damienmaguire/BMW-F11-EV-Conversion/Software/FlexRay/dde-emulator/BASE.md

# Base of the DDE emulator

| What | Where | Commit |
|---|---|---|
| Upstream | https://github.com/dynm/pico-flexray, branch `feature/frame-blocker` | `5c77833ea0b1f9337de2973e54bc3378c0533d34` |
| Local, not on any remote | pass-through build (the known-good firmware) | `9a9ddcc` |
| Local, not on any remote | `ts-capture-fixed` (FIXED timestamped capture build) | `acf675e5693eadddcd28ed0d1cda9be54f53aaa5` |
| Local, not on any remote | `dde-emu-v1h` (this work, v1h.2) | `bc62e95` (v1e was `a2f3321`/`d7e490a`, v1c `60e749b`, v1b `f120e10`, v1 `954110e`) |

History, oldest first:

```
5c77833 Enhance FlexRay functionality by introducing frame blocking and forwarding features. Added flexray_blo
9a9ddcc Pass-through build: disable injection + blocker by default, target Pico 2 (pico2/rp2350-arm-s)
ef2f378 ts-capture FIXED: hardware frame timestamps on the known-good 9a9ddcc pass-through repeater
37fcfba sim: model of flexray_transparent.pio mid-frame TXEN release on real sync frames
7cc598b fr_schedule_analyze: refine_cycle ignores sparse slots (min_len=max(3,nmax//20)), require >=3 slots in
acf675e ts-capture: crc_fail counter in TS info (was uncounted), PICO_FR_USB_FAST option (1 KB vendor IN trans
854bbe3 dde-emu: table generator and bit-level model from run 5 capture
4530346 dde-emu: host-compilable core (frame build, CRC/E2E, schedule, lock FSM) + host test
5698464 dde-emu: firmware (PICO_FLEXRAY_DDE_EMU=ON): transmit DDE static frames on FR1
954110e dde-emu: logger --emulate, emulator stats, Python validation tests   (= v1)
ab10e9c dde-emu v1b: fix false 'TX SM stuck' fault that dropped 0x3D; first-fault record, stats v2
9a7c938 tests: replay car run 1 (f11_emu1.csv) through dde_emu.c on the host
f120e10 logger: read emu stats v2 (128 bytes), show first fault, print EMU FAULT once   (= v1b)
a256526 dde-emu v1c: send dynamic 0xE6/0xFB/0xE8 and the pre-ign statics; stats v3
cd3f70d tests: v1c dynamic frames - run 5 bytes/minislots, run 1/2 replays, unsure cases
64375c7 logger: read emu stats v3 (192 bytes), show the v1c dynamic frames on the emu line
60e749b tests: cross-check v1c against the DDE flash decode (E2E ID 0x37, base/rep, periods, 0xFF fill, FB L7 0xFFF)
fafdba3 dde_emu v1d: 0x5C NM (KL15/NM-gated, 60 s hard ceiling), 0x10A/0x142/0x68, KL15 from 0xF1, FIFO top-up, stats v4
c1ac5fd tests: v1d - 0x142/0x10A/0x68 vs run 5, KL15/NM unit checks, replay KL15/NM model
af3af72 V2 board (Pi_Flex_V2) for the DDE emulator: PT-CAN capture, MCP251863 RX ONLY
366997d logger: emu stats v4 (v1d KL15/NM/ceiling, 0x10A/0x142/0x68), PT-CAN as bus 2, can= counts
29eae7a dde-emu v1e: FlexRay content follows KL15 after off
9653dc9 dde-emu v1e: PT-CAN DDE/EGS frame emulation on the V2 board (opt-in TX)
a2f3321 logger: --can-tx / --can-tx-ids (v1e PT-CAN TX), cantx: status line; run.sh ptcan tests   (= v1e)
d7e490a dde-emu v1e: plain-English comments in the PT-CAN emulator (comments only, V2 UF2 byte-identical)
7dec502 dde-emu v1f WIP: non-blocking console, keep-grid catch-up, NM release 46/30 s, 0x397 blips + OFF walk
55d14fa dde-emu v1f: 16 frames per pass, loop-gap/late stats, own TX logged via the MCP TX event FIFO
46535d5 dde-emu v1f: check_emu_capture.py (own-TX slots, 0x397, foreign IDs, brake signals)   (= v1f)
58cf388 dde-emu v1g: opt-in fake engine start (CAS ST_KL D + brake)
895fe20 dde-emu v1g.2: stop USB record drops; FW_VERSION; logger version check   (= v1g.2)
7514b68 dde-emu v1h: PICO_FR_USB_FAST (1 KB transfers), start profiles short/realistic/run8, echo-miss diagnostics   (= v1h)
d3ebc30 dde-emu v1h.1: gear shifting P/R/N/D (lever 0x197 + brake 0x173), standalone build, checker --gear   (= v1h.1)
bc62e95 dde-emu v1h.2: snapshot reuse (no stale PT-CAN frames), engine/gear out of the FR header ISR, ISR tables in RAM, re-arm guard 70 us, E6 grid fix   (= v1h.2)
```

**v1h.2 patches** (`v1h2/patches/0020..0027`): `git format-patch --start-number 20
d7e490a..` on top of the v1e series (`v1e/patches/0012..0019`). 0020..0026 are
the commits above, unchanged. 0027 is `bc62e95` with one difference: the test
vector `tests/host/run9_ptcan_rx.txt.gz` (all PT-CAN frames received in car run
9) has the immobiliser, VIN and diagnostic IDs (0x80, 0x85, 0x351, 0x380, 0x580,
0x592, 0x598, 0x5C0 and 0x6xx; 144 frames) removed for publication. The test
that uses it gives the same transmitted frames with or without them, and the
host tests (`run.sh`) pass. `source/` carries the same cleaned file.

`source/` is at v1h.2: a rebuild gives the four v1h.2 UF2s byte for byte
(same SHA-256 as `v1h2/firmware/SHA256SUMS`).

`patches/` is the series ts-capture-fixed..dde-emulator. These are 11 patches:
0001–0004 = v1 (`git format-patch ts-capture-fixed..954110e`, unchanged),
0005–0007 = v1b (`git format-patch --start-number 5 954110e..f120e10`, unchanged), and
0008–0011 = v1c (`git format-patch --start-number 8 f120e10..dde-emulator`).
Apply them with `git am patches/*.patch` on a checkout of `ts-capture-fixed`.

`ts-capture-fixed` is not on any remote, so `source/` holds the full source
tree of `dde-emulator` (firmware, tests, tools; no images, web UI or build
output). That tree builds the same code as the shipped v1c UF2: the `.text`
section is byte-identical to the build that made it (checked again for v1c).

With `PICO_FLEXRAY_DDE_EMU=OFF` (the default), the tree builds the FIXED
capture firmware. Every symbol has the same size as in a ts-capture-fixed
build. The UF2 hash differs only because the build path is embedded.
