damienmaguire/BMW-F11-EV-Conversion/F11_DDE_Pinout.ods

Sheet: A460 58-pin
BMW F11 520d DDE (EDC17C50) — Connector A460*2B
58-pin black component connector — Digital diesel electronics
Pin | Type | Description / Signal type | Connection / Measuring information
1 | E | Supply, terminal 87 | Fuse F03
2 | M | Ground | Ground point
3 | E | Supply, terminal 87 | Fuse F03
4 | M | Ground | Ground point
5 | E | Supply, terminal 87 | Fuse F03
6 | M | Ground | Ground point
7 | -- | Not used
8 | A | Activation Cut-out relay, electric fan | Cut-out relay, electric fan
9 | -- | Not used
10 | A | Activation Electric fan | Electric fan
11 | E | Engine start signal | Car access system
12 | E | Supply, terminal 15 | Car access system
13 | A | Activation DDE main relay | DDE main relay
14 | E/A | FlexRay bus signal | Central gateway module
15 | E/A | FlexRay bus signal | Central gateway module
16 | -- | Not used
17 | -- | Not used
18 | E | Wake-up signal | Connector, terminal 15 wake-up signal
19 | -- | Not used
20 | A | Engine start signal | DC/DC converter
21 | A | Speed signal | Diagnosis socket
22 | M | Ground | Engine breather heater
23 | A | Activation Fuel filter heating | Fuel filter heating
24 | -- | Not used
25 | E/A | LIN bus signal | Intelligent battery sensor
26 | -- | Not used
27 | -- | Not used
28 | -- | Not used
29 | -- | Not used
30 | -- | Not used
31 | -- | Not used
32 | -- | Not used
33 | M | Ground | Accelerator pedal module
34 | E | Signal Accelerator pedal module | Accelerator pedal module
35 | A | Supply Accelerator pedal module | Accelerator pedal module
36 | E/A | CAS sub-bus | Car access system
37 | E/A | PT-CAN2 bus signal | PT-CAN2 bus connection
38 | E/A | PT-CAN2 bus signal | PT-CAN2 bus connection
39 | E | Signal Zero-gear sensor | Zero-gear sensor
40 | M | Ground | Zero-gear sensor
41 | M | Ground | Accelerator pedal module
42 | E | Signal Accelerator pedal module | Accelerator pedal module
43 | A | Supply Accelerator pedal module | Accelerator pedal module
44 | -- | Not used
45 | -- | Not used
46 | -- | Not used
47 | -- | Not used
48 | -- | Not used
49 | -- | Not used
50 | -- | Not used
51 | -- | Not used
52 | -- | Not used
53 | A | Supply Zero-gear sensor | Zero-gear sensor
54 | E | Signal Clutch module | Clutch module
55 | E/A | PT-CAN bus signal | PT-CAN bus connection
56 | E/A | PT-CAN bus signal | PT-CAN bus connection
57 | -- | Not used
58 | -- | Not used

Sheet: X2411 96-pin
BMW F11 520d DDE (EDC17C50) — Connector X2411
96-pin black component connector — Digital diesel electronics
Pin | Type | Description / Signal type | Connection / Measuring information
1 | A | Activation Injector 2 | Injector 2
2 | A | Activation Injector 4 | Injector 4
3 | A | Activation Injector 2 | Injector 2
4 | A | Activation Injector 3 | Injector 3
5 | -- | Not used
6 | A | Activation Swirl flap actuator | Swirl flap actuator
7 | A | Activation Swirl flap actuator | Swirl flap actuator
8 | -- | Not used
9 | E | Signal, temperature sensor | Hot-film air mass meter
10 | E | Signal Exhaust temperature sensor before catalytic converter | Exhaust temperature sensor before catalytic converter
11 | M | Ground Exhaust temperature sensor before catalytic converter | Exhaust temperature sensor before catalytic converter
12 | E | Signal Exhaust gas temperature sensor before particle filter | Exhaust gas temperature sensor before particle filter
13 | M | Ground Exhaust gas temperature sensor before particle filter | Exhaust gas temperature sensor before particle filter
14 | M | Ground | Swirl flap actuator
15 | E | Signal Swirl flap actuator | Swirl flap actuator
16 | A | Supply Swirl flap actuator | Swirl flap actuator
17 | E | Signal Charge-air temperature sensor | Charge-air temperature sensor
18 | M | Ground Exhaust-gas temperature sensor after exhaust-gas recirculation cooler | Exhaust-gas temperature sensor after exhaust-gas recirculation cooler
19 | M | Ground Boost pressure actuator | Boost pressure actuator
20 | E | Signal Boost pressure actuator | Boost pressure actuator
21 | -- | Not used
22 | A | 5 V supply | Boost pressure actuator
23 | E/A | BSD bus signal | Alternator
24 | A | Activation Exhaust recirculation actuator | Exhaust recirculation actuator
25 | A | Activation Injector 1 | Injector 1
26 | A | Activation Injector 3 | Injector 3
27 | A | Activation Injector 1 | Injector 1
28 | A | Activation Injector 4 | Injector 4
29 | -- | Not used
30 | M | Ground | Preheating control unit
31 | M | Ground Oil-level sensor | Oil-level sensor
32 | M | Ground | Coolant temperature sensor
33 | E | Signal, temperature sensor | Coolant temperature sensor
34 | E | Oxygen sensor signal | Oxygen sensor after catalytic converter
35 | M | Ground | Oxygen sensor after catalytic converter
36 | E | Oxygen sensor signal | Oxygen sensor after catalytic converter
37 | E | Oxygen sensor signal | Oxygen sensor after catalytic converter
38 | M | Ground | Throttle valve
39 | E | Signal Throttle valve | Throttle valve
40 | A | Supply Throttle valve | Throttle valve
41 | E | Signal Charge-air temperature sensor | Charge-air temperature sensor
42 | E | Signal Exhaust-gas temperature sensor after exhaust-gas recirculation cooler | Exhaust-gas temperature sensor after exhaust-gas recirculation cooler
43 | M | Ground | Exhaust recirculation actuator
44 | E | Signal Exhaust recirculation actuator | Exhaust recirculation actuator
45 | A | Supply Exhaust recirculation actuator | Exhaust recirculation actuator
46 | -- | Not used
47 | -- | Not used
48 | A | Activation Exhaust recirculation actuator | Exhaust recirculation actuator
49 | A | Activation Throttle valve | Throttle valve
50 | A | Activation | Boost pressure actuator
51 | A | Activation Rail pressure control valve | Rail pressure control valve
52 | E | Oxygen sensor signal | Oxygen sensor after catalytic converter
53 | -- | Not used
54 | A | Supply Boost pressure sensor | Boost pressure sensor
55 | E | Signal Boost pressure sensor | Boost pressure sensor
56 | A | Supply Fuel pressure/temperature sensor | Fuel pressure/temperature sensor
57 | E | Signal, temperature sensor | Fuel pressure/temperature sensor
58 | E | Signal, pressure sensor | Fuel pressure/temperature sensor
59 | M | Ground | Fuel pressure/temperature sensor
60 | E | Signal Oxygen sensor before catalytic converter | Oxygen sensor before catalytic converter
61 | M | Ground | Oxygen sensor before catalytic converter
62 | M | Ground Exhaust backpressure sensor | Exhaust backpressure sensor
63 | E | Signal Exhaust backpressure sensor | Exhaust backpressure sensor
64 | A | Supply Exhaust backpressure sensor | Exhaust backpressure sensor
65 | E | Signal, temperature sensor | Hot-film air mass meter
66 | -- | Not used
67 | E | Signal Oil-level sensor | Oil-level sensor
68 | E | Signal, pressure sensor | Oil pressure switch
69 | -- | Not used
70 | E/A | LIN bus signal | Preheating control unit
71 | -- | Not used
72 | -- | Not used
73 | A | Activation Throttle valve | Throttle valve
74 | A | Activation | Boost pressure actuator
75 | -- | Not used
76 | A | Activation | Electric changeover valve, engine mount
77 | A | Activation Electric changeover valve, bypass valve, EGR cooler | Electric changeover valve, bypass valve, EGR cooler
78 | M | Ground | Boost pressure sensor
79 | M | Ground Exhaust pressure sensor before turbocharger | Exhaust pressure sensor before turbocharger
80 | E | Signal Exhaust pressure sensor before turbocharger | Exhaust pressure sensor before turbocharger
81 | A | Supply Exhaust pressure sensor before turbocharger | Exhaust pressure sensor before turbocharger
82 | E | Signal Camshaft sensor | Camshaft sensor
83 | M | Sensor ground | Camshaft sensor
84 | E | Signal Oxygen sensor before catalytic converter | Oxygen sensor before catalytic converter
85 | E | Signal Oxygen sensor before catalytic converter | Oxygen sensor before catalytic converter
86 | M | Ground Rail pressure sensor | Rail pressure sensor
87 | E | Signal Rail pressure sensor | Rail pressure sensor
88 | A | Supply Rail pressure sensor | Rail pressure sensor
89 | E | Signal, temperature sensor | Hot-film air mass meter
90 | M | Ground | Hot-film air mass meter
91 | M | Ground | Crankshaft sensor
92 | E | Signal Crankshaft sensor | Crankshaft sensor
93 | A | Supply Crankshaft sensor | Crankshaft sensor
94 | E | Signal Oxygen sensor before catalytic converter | Oxygen sensor before catalytic converter
95 | -- | Not used
96 | A | Activation Volume control valve | Volume control valve

Sheet: Notes
Notes — BMW F11 520d DDE Pinout
Source: BMW ISTA / TIS pin assignment for A460*2B and X2411 on the EDC17C50 (N47, F11 520d).
Type codes:
E = Input
A = Output / Activation
E/A = Bidirectional
M = Ground
-- = Not used
Key pins for the EV conversion / emulator:
A460*2B pins 14 & 15 — FlexRay bus signals (to central gateway)
A460*2B pins 1, 3, 5 — Terminal 87 (+12 V supply)
A460*2B pins 2, 4, 6 — Ground
A460*2B pin 12 — Terminal 15
A460*2B pin 18 — Wake-up signal
A460*2B pins 33–35 & 41–43 — Accelerator pedal module (dual track)
Colour coding in the sheets:
Green = FlexRay
Yellow = Terminal 87 power
Blue = Main grounds (pins 2/4/6)
Grey = Not used
Created for the F11 520d EV conversion project.
