damienmaguire/BMW-F11-EV-Conversion/Design/FlexRay/Pi_Flex_V1_3D.jpg

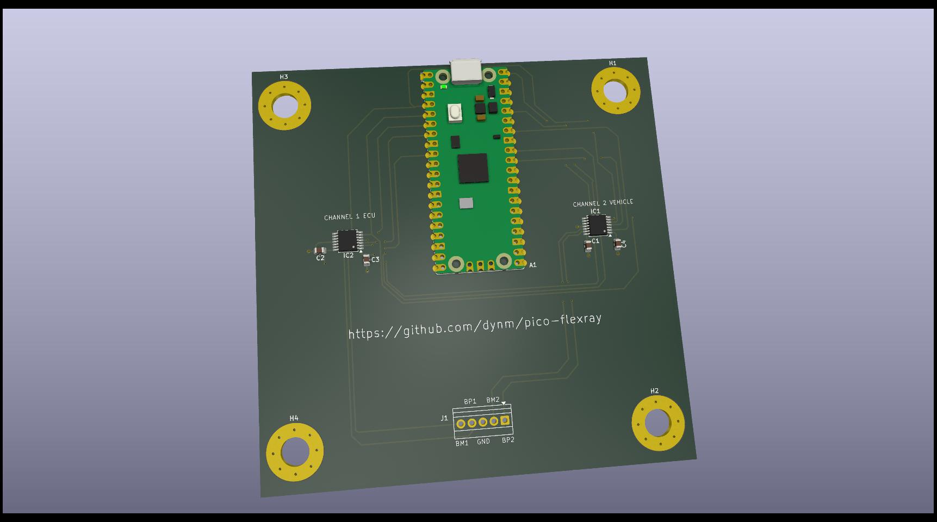
Design/FlexRay/Pi_Flex_V1_3D.jpg
