damienmaguire/BMW-F11-EV-Conversion/Design/FlexRay/Pi_Flex_V1.kicad_pcb

## KiCad design Design/FlexRay/Pi_Flex_V1.kicad_pcb (2026-10-28)

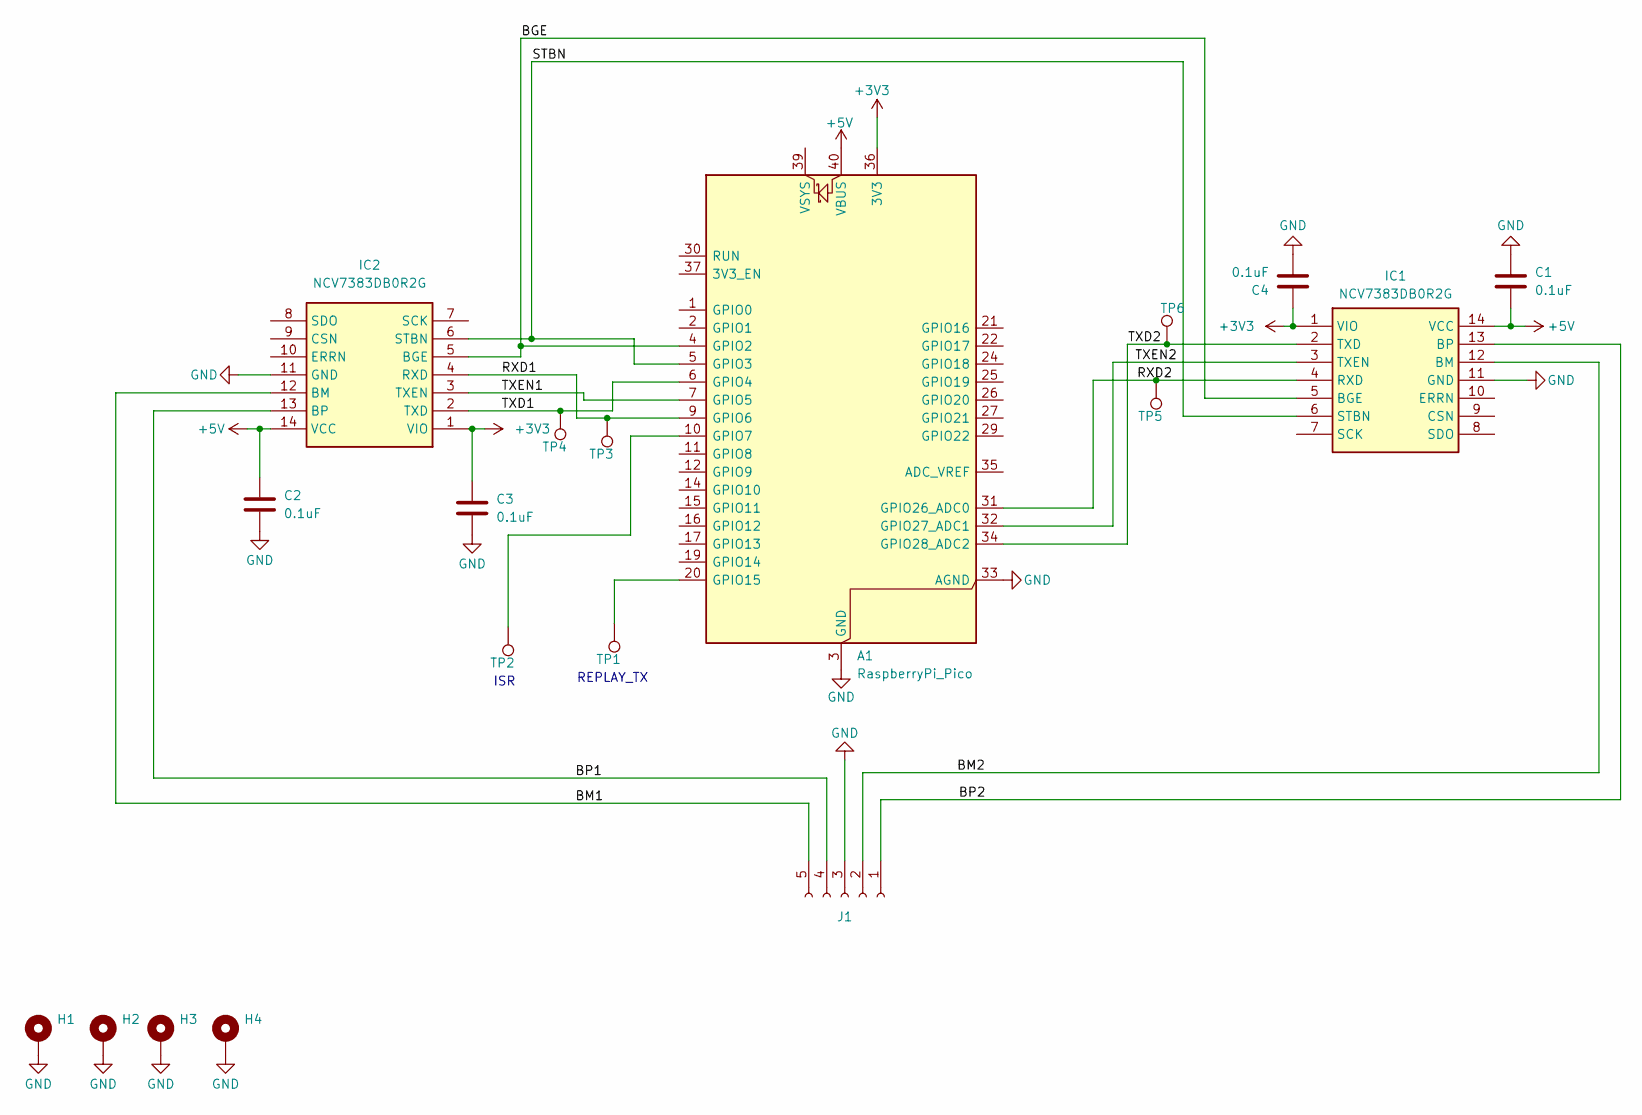
[picture p3: schematic Pi_Flex_V1.kicad_sch]

Parts:
A1: RaspberryPi_Pico; RaspberryPi_Pico_Common_Unspecified
C1, C2, C3, C4: 0.1uF; C_0805_2012Metric
H1, H2, H3, H4: MountingHole_Pad; MountingHole_6.4mm_M6_Pad_Via
IC1, IC2: NCV7383DB0R2G; TSSOP-14_4.4x5mm_P0.65mm; Manufacturer_Part_Number NCV7383DB0R2G; Mouser Part Number 863-NCV7383DB0R2G
J1: Conn_01x05_Socket; TerminalBlock_Xinya_XY308-2.54-5P_1x05_P2.54mm_Horizontal
TP1, TP2, TP3, TP4, TP5, TP6: TestPoint; TestPoint_THTPad_D2.5mm_Drill1.2mm

Connections:
+3V3: A1.36 (3V3), C3.1, C4.1, IC1.1 (VIO), IC2.1 (VIO)
+5V: A1.40 (VBUS), C1.2, C2.1, IC1.14 (VCC), IC2.14 (VCC)
/BGE: A1.4 (GPIO2), IC1.5 (BGE), IC2.5 (BGE)
/BM1: IC2.12 (BM), J1.5
/BM2: IC1.12 (BM), J1.2
/BP1: IC2.13 (BP), J1.4
/BP2: IC1.13 (BP), J1.1
/RXD1: A1.9 (GPIO6), IC2.4 (RXD), TP3.1
/RXD2: A1.31 (GPIO26_ADC0), IC1.4 (RXD), TP5.1
/STBN: A1.5 (GPIO3), IC1.6 (STBN), IC2.6 (STBN)
/TXD1: A1.6 (GPIO4), IC2.2 (TXD), TP4.1
/TXD2: A1.34 (GPIO28_ADC2), IC1.2 (TXD), TP6.1
/TXEN1: A1.7 (GPIO5), IC2.3 (TXEN)
/TXEN2: A1.32 (GPIO27_ADC1), IC1.3 (TXEN)
GND: A1.3 (GND), A1.8 (GND), A1.13 (GND), A1.18 (GND), A1.23 (GND), A1.28 (GND), A1.33 (AGND), A1.38 (GND), C1.1, C2.2, C3.2, C4.2, H1.1, H2.1, H3.1, H4.1, IC1.11 (GND), IC2.11 (GND), J1.3
unnamed: A1.10 (GPIO7), TP2.1
unnamed: A1.20 (GPIO15), TP1.1

Notes on the sheet:
ISR
REPLAY_TX

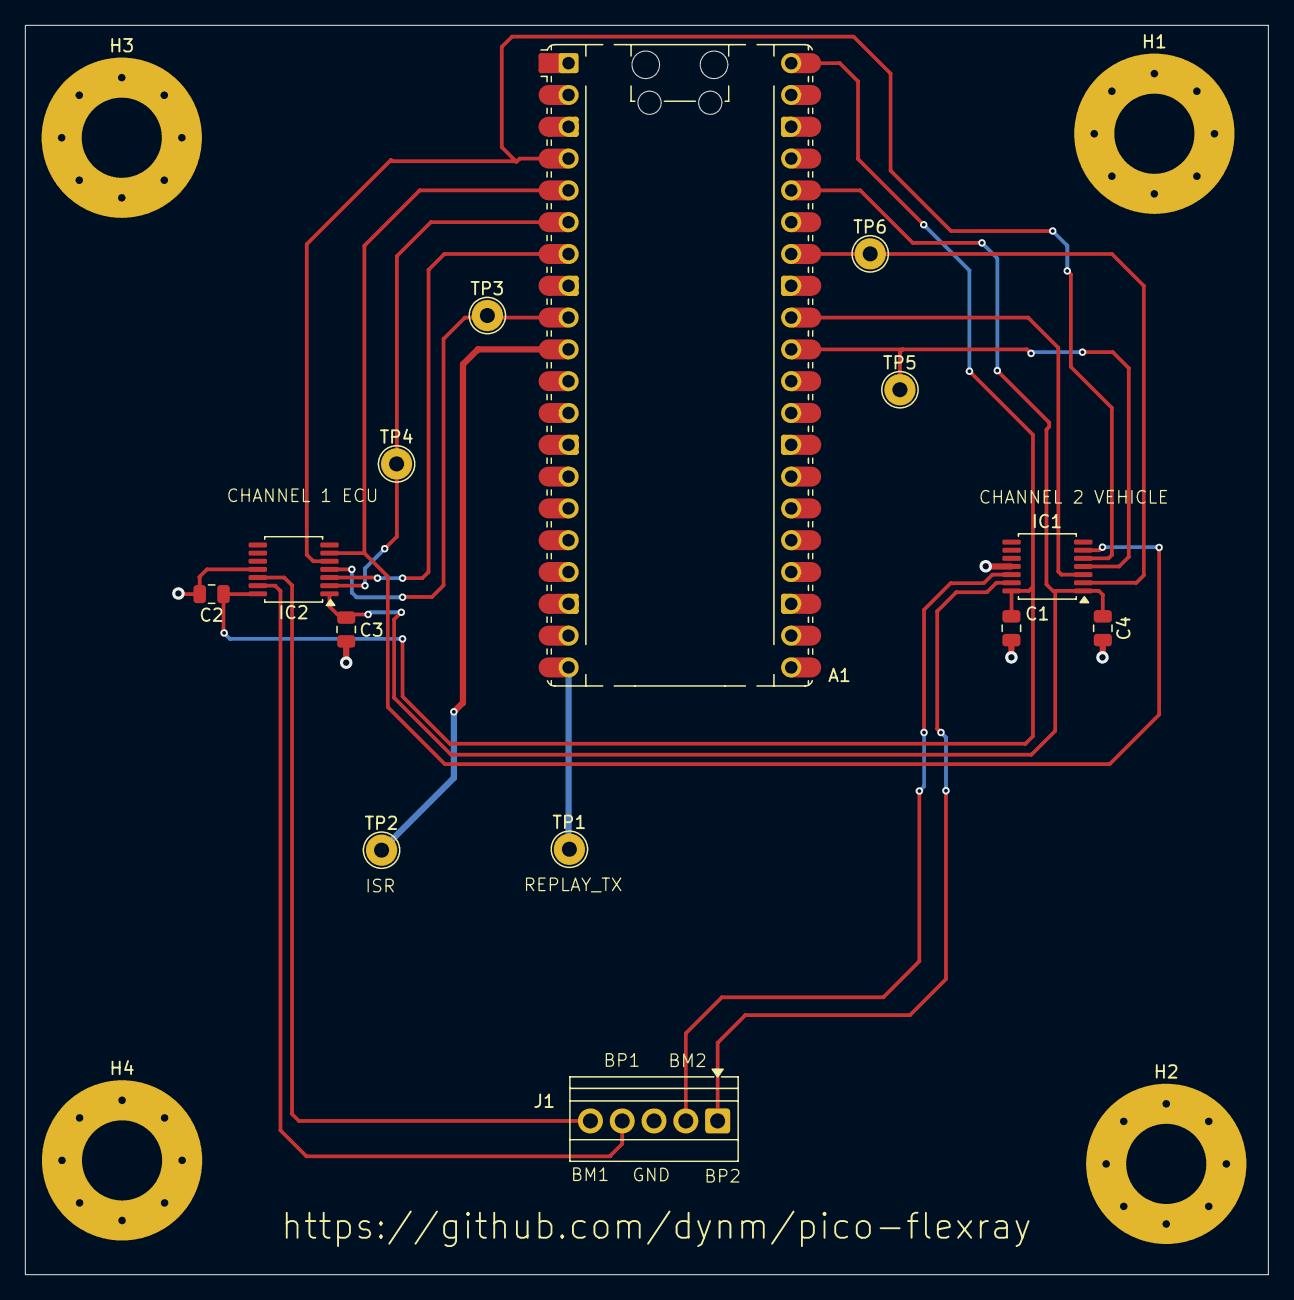
[picture p4: board Pi_Flex_V1.kicad_pcb from above]

Board: 2 copper layers, 99.3 x 99.8 mm, 18 parts (0 on the bottom side), 17 nets.
