damienmaguire/BMW-F11-EV-Conversion/Software/FlexRay/dde-emulator/source/src/flexray_bss_streamer.c

#include "pico/stdlib.h"
#include "hardware/sync.h"
#include "hardware/pio.h"
#include "hardware/dma.h"
#include "hardware/irq.h"
#include "hardware/clocks.h"
#include "hardware/timer.h"

#include "flexray_bss_streamer.pio.h"
#include "flexray_bss_streamer.h"
#include "flexray_blocker.h"
#include "flexray_frame.h"
#include "flexray_injector.h"
#include "flexray_pins.h"
#include "flexray_ts.h"
#if PICO_FLEXRAY_DDE_EMU
#include "dde_emu.h"
#endif

// ===================== FR1/FR2 (primary) stream state =====================
uint dma_data_from_fr1_chan;
uint dma_data_from_fr2_chan;
static uint dma_rearm_fr1_chan;
static uint dma_rearm_fr2_chan;

static PIO streamer_pio;

volatile uint8_t fr1_ring_buffer[FR1_RING_SIZE_BYTES] __attribute__((aligned(FR1_RING_SIZE_BYTES)));
volatile uint8_t fr2_ring_buffer[FR2_RING_SIZE_BYTES] __attribute__((aligned(FR2_RING_SIZE_BYTES)));

static volatile uint32_t fr1_prev_write_idx = 0;
static volatile uint32_t fr2_prev_write_idx = 0;

// ===================== FR3/FR4 (secondary) stream state =====================
static uint dma_data_from_fr3_chan;
static uint dma_data_from_fr4_chan;
static uint dma_rearm_fr3_chan;
static uint dma_rearm_fr4_chan;

static PIO streamer_pio_fr34;

volatile uint8_t fr3_ring_buffer[FR3_RING_SIZE_BYTES] __attribute__((aligned(FR3_RING_SIZE_BYTES)));
volatile uint8_t fr4_ring_buffer[FR4_RING_SIZE_BYTES] __attribute__((aligned(FR4_RING_SIZE_BYTES)));

static volatile uint32_t fr3_prev_write_idx = 0;
static volatile uint32_t fr4_prev_write_idx = 0;
static volatile uint8_t fr34_detected_source = FROM_UNKNOWN;

// ===================== Shared state =====================
#define DMA_BLOCK_COUNT_BYTES  (4096u | 0x10000000) // self trigger
static volatile uint32_t notify_seq = 0;
flexray_stream_diag_t flexray_stream_diag;
volatile uint16_t flexray_unknown_source_ids[32];
volatile uint32_t flexray_unknown_source_idx;
volatile flexray_isr_profile_t flexray_isr_profile;

volatile int dma_inject_chan_to_fr1 = -1;
volatile int dma_inject_chan_to_fr2 = -1;
volatile int dma_inject_chan_to_fr3 = -1;
volatile int dma_inject_chan_to_fr4 = -1;

static inline uint32_t dma_ring_write_idx(uint dma_chan, volatile uint8_t *ring_base, uint32_t ring_mask)
{
    uint32_t wa = dma_channel_hw_addr(dma_chan)->write_addr;
    return (wa - (uint32_t)(uintptr_t)ring_base) & ring_mask;
}

static inline uint8_t dma_ring_size_bits(uint32_t ring_size_bytes)
{
    return ring_size_bytes > 1u ? (uint8_t)(32u - __builtin_clz(ring_size_bytes - 1u)) : 0u;
}

static inline void setup_header_end_irqs(PIO pio,
                                         irq_handler_t header_handler,
                                         irq_handler_t end_handler)
{
    pio_set_irq0_source_enabled(pio, pis_interrupt4, true);
    irq_set_exclusive_handler(pio_get_irq_num(pio, 0), header_handler);
    irq_set_enabled(pio_get_irq_num(pio, 0), true);

    pio_set_irq1_source_enabled(pio, pis_interrupt3, true);
    irq_set_exclusive_handler(pio_get_irq_num(pio, 1), end_handler);
    irq_set_enabled(pio_get_irq_num(pio, 1), true);
}

// ===================== Cross-core notification ring =====================
#define NOTIFY_RING_SIZE 1024u
static volatile uint32_t notify_ring[NOTIFY_RING_SIZE];
static volatile uint16_t notify_head = 0;
static volatile uint16_t notify_tail = 0;
static volatile uint32_t notify_dropped = 0;

static inline void record_fr34_detected_source(bool is_fr4)
{
    fr34_detected_source = is_fr4 ? FROM_FR4 : FROM_FR3;
}

static inline uint16_t header_crc_from_header(const uint8_t *header)
{
    return (uint16_t)(((uint16_t)(header[2] & 0x01) << 10) |
                      ((uint16_t)header[3] << 2) |
                      ((header[4] >> 6) & 0x03));
}

static inline void ring_copy_header_from_start(uint8_t *header,
                                               const volatile uint8_t *ring_base,
                                               uint32_t start,
                                               uint32_t ring_mask)
{
    for (uint32_t i = 0; i < 5u; i++) {
        header[i] = ring_base[(start + i) & ring_mask];
    }
}

static inline void process_fr12_header_from_ring(volatile uint8_t *ring_base,
                                                 uint32_t start,
                                                 uint32_t ring_mask)
{
    uint8_t header[5];
    ring_copy_header_from_start(header, ring_base, start, ring_mask);
    if (calculate_flexray_header_crc(header) != header_crc_from_header(header)) {
        flexray_stream_diag.fr12_header_crc_fail++;
        return;
    }

    uint16_t frame_id = (uint16_t)(((uint16_t)(header[0] & 0x07) << 8) | header[1]);
    uint8_t cycle_count = (uint8_t)(header[4] & 0x3F);
#if PICO_FLEXRAY_DDE_EMU
    if (ring_base == fr1_ring_buffer) {
        dde_emu_on_fr1_header(header, start, ring_mask);
    }
#endif
    (void)prepare_inject_frame(frame_id, cycle_count);

    uint8_t direction_mask = flexray_filter_block_mask_for_id(frame_id);
    direction_mask &= (uint8_t)~injector_block_exclusion_mask_for_frame(frame_id, cycle_count);
    if (direction_mask != 0u) {
        flexray_blocker_suppress_direction_mask(direction_mask);
    }
}

static inline void service_fr12_header_irq(void)
{
    uint32_t fr1_delta = (dma_ring_write_idx(dma_data_from_fr1_chan,
                                             fr1_ring_buffer,
                                             FR1_RING_MASK) -
                          fr1_prev_write_idx) &
                         FR1_RING_MASK;
    uint32_t fr2_delta = (dma_ring_write_idx(dma_data_from_fr2_chan,
                                             fr2_ring_buffer,
                                             FR2_RING_MASK) -
                          fr2_prev_write_idx) &
                         FR2_RING_MASK;

    if (fr2_delta >= 5u) {
        process_fr12_header_from_ring(fr2_ring_buffer, fr2_prev_write_idx, FR2_RING_MASK);
    } else if (fr1_delta >= 5u) {
        process_fr12_header_from_ring(fr1_ring_buffer, fr1_prev_write_idx, FR1_RING_MASK);
    } else {
        flexray_stream_diag.fr12_header_no_candidate++;
    }
}

static inline bool record_fr34_source_from_header(bool is_fr4,
                                                  const volatile uint8_t *ring_base,
                                                  uint32_t start,
                                                  uint32_t ring_mask)
{
    uint8_t header[5];
    ring_copy_header_from_start(header, ring_base, start, ring_mask);
    if (calculate_flexray_header_crc(header) != header_crc_from_header(header)) {
        flexray_stream_diag.fr34_header_crc_fail++;
        fr34_detected_source = FROM_UNKNOWN;
        return false;
    }

    record_fr34_detected_source(is_fr4);
    return true;
}

static inline void isr_profile_add(volatile flexray_isr_profile_counter_t *counter,
                                   uint32_t started_us)
{
    uint32_t elapsed = time_us_32() - started_us;
    counter->count++;
    counter->total_us += elapsed;
    if (elapsed > counter->max_us) {
        counter->max_us = elapsed;
    }
}

static inline void service_fr34_header_irq(void)
{
    uint32_t fr3_idx = dma_ring_write_idx(dma_data_from_fr3_chan,
                                          fr3_ring_buffer,
                                          FR3_RING_MASK);
    uint32_t fr4_idx = dma_ring_write_idx(dma_data_from_fr4_chan,
                                          fr4_ring_buffer,
                                          FR4_RING_MASK);
    uint32_t fr3_delta = (fr3_idx -
                          fr3_prev_write_idx) &
                         FR3_RING_MASK;
    uint32_t fr4_delta = (fr4_idx -
                          fr4_prev_write_idx) &
                         FR4_RING_MASK;

    if (fr4_delta >= 5u) {
        if (record_fr34_source_from_header(true, fr4_ring_buffer, fr4_prev_write_idx, FR4_RING_MASK)) {
            flexray_stream_diag.fr34_header_record_fr4++;
        }
    } else if (fr3_delta >= 5u) {
        if (record_fr34_source_from_header(false, fr3_ring_buffer, fr3_prev_write_idx, FR3_RING_MASK)) {
            flexray_stream_diag.fr34_header_record_fr3++;
        }
    } else {
        fr34_detected_source = FROM_UNKNOWN;
        flexray_stream_diag.fr34_header_no_candidate++;
    }
}

void notify_queue_init(void)
{
    notify_head = 0;
    notify_tail = 0;
    notify_dropped = 0;
}

static inline bool notify_queue_push(uint32_t value)
{
    uint16_t head = notify_head;
    uint16_t next = (uint16_t)((head + 1u) & (NOTIFY_RING_SIZE - 1u));
    if (next == notify_tail)
    {
        notify_dropped++;
        return false;
    }
    notify_ring[head] = value;
    notify_head = next;
    __sev();
    return true;
}

bool notify_queue_pop(uint32_t *encoded)
{
    uint16_t tail = notify_tail;
    if (tail == notify_head)
    {
        return false;
    }
    *encoded = notify_ring[tail];
    notify_tail = (uint16_t)((tail + 1u) & (NOTIFY_RING_SIZE - 1u));
    return true;
}

uint32_t notify_queue_dropped(void)
{
    return notify_dropped;
}

// ===================== FR1/FR2 header IRQ handler =====================
void __time_critical_func(streamer_header_irq_handler)(void)
{
    uint32_t started_us = time_us_32();
    flexray_stream_diag.fr12_header_irq++;
    pio_interrupt_clear(streamer_pio, 4);
    service_fr12_header_irq();
    isr_profile_add(&flexray_isr_profile.fr12_header, started_us);
}

// ===================== FR1/FR2 frame-end IRQ handler =====================
void __time_critical_func(streamer_frame_end_irq_handler)(void)
{
    uint32_t started_us = time_us_32();

    pio_interrupt_clear(streamer_pio, 3);

    uint32_t fr1_idx_now = dma_ring_write_idx(dma_data_from_fr1_chan, fr1_ring_buffer, FR1_RING_MASK);
    uint32_t fr2_idx_now = dma_ring_write_idx(dma_data_from_fr2_chan, fr2_ring_buffer, FR2_RING_MASK);

    uint32_t fr1_delta = (fr1_idx_now - fr1_prev_write_idx) & FR1_RING_MASK;
    uint32_t fr2_delta = (fr2_idx_now - fr2_prev_write_idx) & FR2_RING_MASK;
    bool is_fr2 = fr2_delta > fr1_delta;
    uint32_t idx = is_fr2 ? fr2_idx_now : fr1_idx_now;

    if (is_fr2) {
        fr2_prev_write_idx = fr2_idx_now;
    } else {
        fr1_prev_write_idx = fr1_idx_now;
    }

    uint8_t fr34_source = fr34_detected_source;
    fr34_detected_source = FROM_UNKNOWN;
    if (fr34_source == FROM_UNKNOWN) {
        flexray_stream_diag.source_lookup_unknown_empty++;
    }

    injector_note_frame_end();
    flexray_blocker_release_all();
    inject_prepared_frame();

    uint32_t encoded = notify_encode(is_fr2, fr34_source, ((notify_seq++) & 0x1FFFF), (uint16_t)idx);
    (void)notify_queue_push(encoded);
    isr_profile_add(&flexray_isr_profile.fr12_end, started_us);
}

// ===================== FR3/FR4 header IRQ handler =====================
void __time_critical_func(streamer_fr34_header_irq_handler)(void)
{
    uint32_t started_us = time_us_32();
    flexray_stream_diag.fr34_header_irq++;
    pio_interrupt_clear(streamer_pio_fr34, 4);
    service_fr34_header_irq();
    isr_profile_add(&flexray_isr_profile.fr34_header, started_us);
}

// ===================== FR3/FR4 frame-end IRQ handler =====================
void __time_critical_func(streamer_fr34_frame_end_irq_handler)(void)
{
    uint32_t started_us = time_us_32();
    flexray_stream_diag.fr34_frame_end_irq++;
    pio_interrupt_clear(streamer_pio_fr34, 3);

    uint32_t fr3_idx_now = dma_ring_write_idx(dma_data_from_fr3_chan, fr3_ring_buffer, FR3_RING_MASK);
    uint32_t fr4_idx_now = dma_ring_write_idx(dma_data_from_fr4_chan, fr4_ring_buffer, FR4_RING_MASK);
    bool fr3_advanced = fr3_idx_now != fr3_prev_write_idx;
    bool fr4_advanced = fr4_idx_now != fr4_prev_write_idx;

    if (fr3_advanced && fr4_advanced) {
        flexray_stream_diag.fr34_frame_end_both_advanced++;
    } else if (fr3_advanced) {
        flexray_stream_diag.fr34_frame_end_fr3_only++;
    } else if (fr4_advanced) {
        flexray_stream_diag.fr34_frame_end_fr4_only++;
    } else {
        flexray_stream_diag.fr34_frame_end_no_advance++;
    }

    if (fr3_advanced) {
        fr3_prev_write_idx = fr3_idx_now;
    }

    if (fr4_advanced) {
        fr4_prev_write_idx = fr4_idx_now;
    }

    isr_profile_add(&flexray_isr_profile.fr34_end, started_us);
}

// ===================== FR1/FR2 setup =====================
#if PICO_FLEXRAY_DDE_EMU
static void emu_streamer_init(PIO pio, uint sm, uint offset, uint rx_pin, uint mark_pin)
{
    pio_sm_set_pins_with_mask(pio, sm, 1u << mark_pin, 1u << mark_pin);   // mark idles high
    pio_sm_set_consecutive_pindirs(pio, sm, rx_pin, 1, false);
    pio_sm_set_consecutive_pindirs(pio, sm, mark_pin, 1, true);
    pio_gpio_init(pio, mark_pin);
    pio_sm_config c = flexray_bss_streamer_program_get_default_config(offset);
    sm_config_set_in_pins(&c, rx_pin);
    sm_config_set_jmp_pin(&c, rx_pin);
    sm_config_set_sideset_pins(&c, mark_pin);
    sm_config_set_out_pins(&c, mark_pin, 0);   // 'mov pins, pins' writes no pin
    float div = (float)clock_get_hz(clk_sys) / (10 * 1000000 * 10);
    sm_config_set_clkdiv(&c, div);
    pio_sm_init(pio, sm, offset, &c);
}
#endif

void setup_stream(PIO pio)
{
    streamer_pio = pio;

    uint offset = pio_add_program(pio, &flexray_bss_streamer_program);
    uint sm_fr1 = pio_claim_unused_sm(pio, true);
    uint sm_fr2 = pio_claim_unused_sm(pio, true);

#if PICO_FLEXRAY_DDE_EMU
    // Emulator: only the FR1 receiver runs. Its side-set frame-start mark goes to
    // GP25 (no header pin) instead of TXEN_FR_2, and its 'mov pins, pins' drives
    // nothing (out count 0). The FR2 SM is claimed but never started: it would
    // drive TXEN_FR_1, which the emulator's TX state machine owns.
    emu_streamer_init(pio, sm_fr1, offset, RXD_FR_1_PIN, DDE_EMU_MARK_PIN);
#else
    flexray_bss_streamer_program_init(pio, sm_fr1, offset, RXD_FR_1_PIN, TXEN_FR_2_PIN);
    flexray_bss_streamer_program_init(pio, sm_fr2, offset, RXD_FR_2_PIN, TXEN_FR_1_PIN);
#endif
    dma_data_from_fr1_chan = dma_claim_unused_channel(true);
    dma_data_from_fr2_chan = dma_claim_unused_channel(true);
    dma_channel_config dma_c_fr1 = dma_channel_get_default_config(dma_data_from_fr1_chan);
    dma_channel_config dma_c_fr2 = dma_channel_get_default_config(dma_data_from_fr2_chan);
    channel_config_set_transfer_data_size(&dma_c_fr1, DMA_SIZE_8);
    channel_config_set_transfer_data_size(&dma_c_fr2, DMA_SIZE_8);
    channel_config_set_read_increment(&dma_c_fr1, false);
    channel_config_set_read_increment(&dma_c_fr2, false);
    channel_config_set_write_increment(&dma_c_fr1, true);
    channel_config_set_write_increment(&dma_c_fr2, true);
    channel_config_set_dreq(&dma_c_fr1, pio_get_dreq(pio, sm_fr1, false));
    channel_config_set_dreq(&dma_c_fr2, pio_get_dreq(pio, sm_fr2, false));

    channel_config_set_ring(&dma_c_fr1, true, dma_ring_size_bits(FR1_RING_SIZE_BYTES));
    channel_config_set_ring(&dma_c_fr2, true, dma_ring_size_bits(FR2_RING_SIZE_BYTES));
    dma_rearm_fr1_chan = dma_claim_unused_channel(true);
    dma_rearm_fr2_chan = dma_claim_unused_channel(true);
    channel_config_set_chain_to(&dma_c_fr1, dma_rearm_fr1_chan);
    channel_config_set_chain_to(&dma_c_fr2, dma_rearm_fr2_chan);

    dma_channel_configure(dma_data_from_fr1_chan, &dma_c_fr1,
                          (void *)fr1_ring_buffer,
                          &pio->rxf[sm_fr1],
                          DMA_BLOCK_COUNT_BYTES,
                          true);
    dma_channel_configure(dma_data_from_fr2_chan, &dma_c_fr2,
                          (void *)fr2_ring_buffer,
                          &pio->rxf[sm_fr2],
                          DMA_BLOCK_COUNT_BYTES,
                          true);

    setup_header_end_irqs(pio, streamer_header_irq_handler, streamer_frame_end_irq_handler);

    // TS-CAPTURE (FIXED): read-only tsmark SMs on the TXEN pins this streamer drives,
    // + DMA timestamp chains. Streamer program/clkdiv/pins untouched.
#if PICO_FLEXRAY_DDE_EMU
    // side 0 = FR1 frame-start marks (GP25), side 1 = our own TXEN_FR_1 (transmit marks)
    flexray_ts_setup(pio, DDE_EMU_MARK_PIN, TXEN_FR_1_PIN,
                     dma_data_from_fr1_chan, dma_data_from_fr2_chan,
                     fr1_ring_buffer, fr2_ring_buffer);
#elif !PICO_FLEXRAY_TS_DISABLE
    flexray_ts_setup(pio, TXEN_FR_2_PIN, TXEN_FR_1_PIN,
                     dma_data_from_fr1_chan, dma_data_from_fr2_chan,
                     fr1_ring_buffer, fr2_ring_buffer);
#endif

    pio_interrupt_clear(pio, 3);
    pio_interrupt_clear(pio, 4);
    pio_interrupt_clear(pio, 7);
    pio_sm_set_enabled(pio, sm_fr1, true);
#if !PICO_FLEXRAY_DDE_EMU
    pio_sm_set_enabled(pio, sm_fr2, true);
#endif
}

// ===================== FR3/FR4 setup =====================
void setup_stream_fr34(PIO pio)
{
    streamer_pio_fr34 = pio;

    uint offset = pio_add_program(pio, &flexray_bss_streamer_program);
    uint sm_fr3 = pio_claim_unused_sm(pio, true);
    uint sm_fr4 = pio_claim_unused_sm(pio, true);

    flexray_bss_streamer_program_init(pio, sm_fr3, offset, RXD_FR_3_PIN, TXEN_FR_4_PIN);
    flexray_bss_streamer_program_init(pio, sm_fr4, offset, RXD_FR_4_PIN, TXEN_FR_3_PIN);

    dma_data_from_fr3_chan = dma_claim_unused_channel(true);
    dma_data_from_fr4_chan = dma_claim_unused_channel(true);
    dma_channel_config dma_c_fr3 = dma_channel_get_default_config(dma_data_from_fr3_chan);
    dma_channel_config dma_c_fr4 = dma_channel_get_default_config(dma_data_from_fr4_chan);
    channel_config_set_transfer_data_size(&dma_c_fr3, DMA_SIZE_8);
    channel_config_set_transfer_data_size(&dma_c_fr4, DMA_SIZE_8);
    channel_config_set_read_increment(&dma_c_fr3, false);
    channel_config_set_read_increment(&dma_c_fr4, false);
    channel_config_set_write_increment(&dma_c_fr3, true);
    channel_config_set_write_increment(&dma_c_fr4, true);
    channel_config_set_dreq(&dma_c_fr3, pio_get_dreq(pio, sm_fr3, false));
    channel_config_set_dreq(&dma_c_fr4, pio_get_dreq(pio, sm_fr4, false));

    channel_config_set_ring(&dma_c_fr3, true, dma_ring_size_bits(FR3_RING_SIZE_BYTES));
    channel_config_set_ring(&dma_c_fr4, true, dma_ring_size_bits(FR4_RING_SIZE_BYTES));

    dma_rearm_fr3_chan = dma_claim_unused_channel(true);
    dma_rearm_fr4_chan = dma_claim_unused_channel(true);
    channel_config_set_chain_to(&dma_c_fr3, dma_rearm_fr3_chan);
    channel_config_set_chain_to(&dma_c_fr4, dma_rearm_fr4_chan);

    dma_channel_configure(dma_data_from_fr3_chan, &dma_c_fr3,
                          (void *)fr3_ring_buffer,
                          &pio->rxf[sm_fr3],
                          DMA_BLOCK_COUNT_BYTES,
                          true);
    dma_channel_configure(dma_data_from_fr4_chan, &dma_c_fr4,
                          (void *)fr4_ring_buffer,
                          &pio->rxf[sm_fr4],
                          DMA_BLOCK_COUNT_BYTES,
                          true);

    setup_header_end_irqs(pio, streamer_fr34_header_irq_handler, streamer_fr34_frame_end_irq_handler);

    pio_interrupt_clear(pio, 3);
    pio_interrupt_clear(pio, 4);
    pio_interrupt_clear(pio, 7);
    pio_sm_set_enabled(pio, sm_fr3, true);
    pio_sm_set_enabled(pio, sm_fr4, true);
}

#if PICO_FLEXRAY_DDE_EMU
// v1h: header counters for the DDE emulator's echo-miss diagnostics (USB 0xaa)
// v1h.2: in RAM - it is called from fire_slot (alarm ISR) for every static frame; from
// flash it was an XIP fetch that can stall behind core 0's flash traffic (USB, printf)
void __not_in_flash_func(dde_emu_stream_counts)(uint32_t *crc_fail, uint32_t *no_cand)
{
    *crc_fail = flexray_stream_diag.fr12_header_crc_fail;
    *no_cand = flexray_stream_diag.fr12_header_no_candidate;
}
#endif
