damienmaguire/BMW-F11-EV-Conversion/(commit log)

2026-10-28 Add design for pi flexray capture board
2026-10-30 DDE emulator v1 (ign-on, untested): forwarder header/PIO, frame (7/16)
2026-10-30 dde-emu v1b: host test struct/sync/timer stubs (5/8)
2026-10-30 dde-emu v1b: pico stub, sim_hw, run.sh, replay test (6/8)
2026-10-30 dde-emu v1c: patch 0011, dynamic-frame run 5 reference, extract_dyn (6/6)
2026-11-01 dde-emu v1h.2: release folder (V1/V2 ignon + standalone UF2s, tools, patches 0020-0027), source tree to v1h.2, CHANGELOG, car test notes runs 6-10
    - v1h2/: four UF2s with SHA256SUMS (verified), logger v1h.2 (fr_ts_logger.py, frts.py),
    check_emu_capture.py + dde_emu_model.py, build README.txt, plain-English README.md
    with the run 10 result and the known small issues for v1h.3
    - source/: full tree at pico-flexray bc62e95 (dde-emu-v1h); rebuild matches all four UF2s
    byte for byte. The run 9 PT-CAN test vector has immobiliser, VIN and diagnostic IDs removed
    - v1h2/patches/0020-0027: d7e490a..bc62e95 on top of the v1e series (0027 carries the cleaned vector)
    - CHANGELOG.md: v1f to v1h.2 in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
